fubarlabs/tartan-fubar/pcb/tartan.kicad_pcb

## KiCad design pcb/tartan.kicad_pcb (2024-03-26)

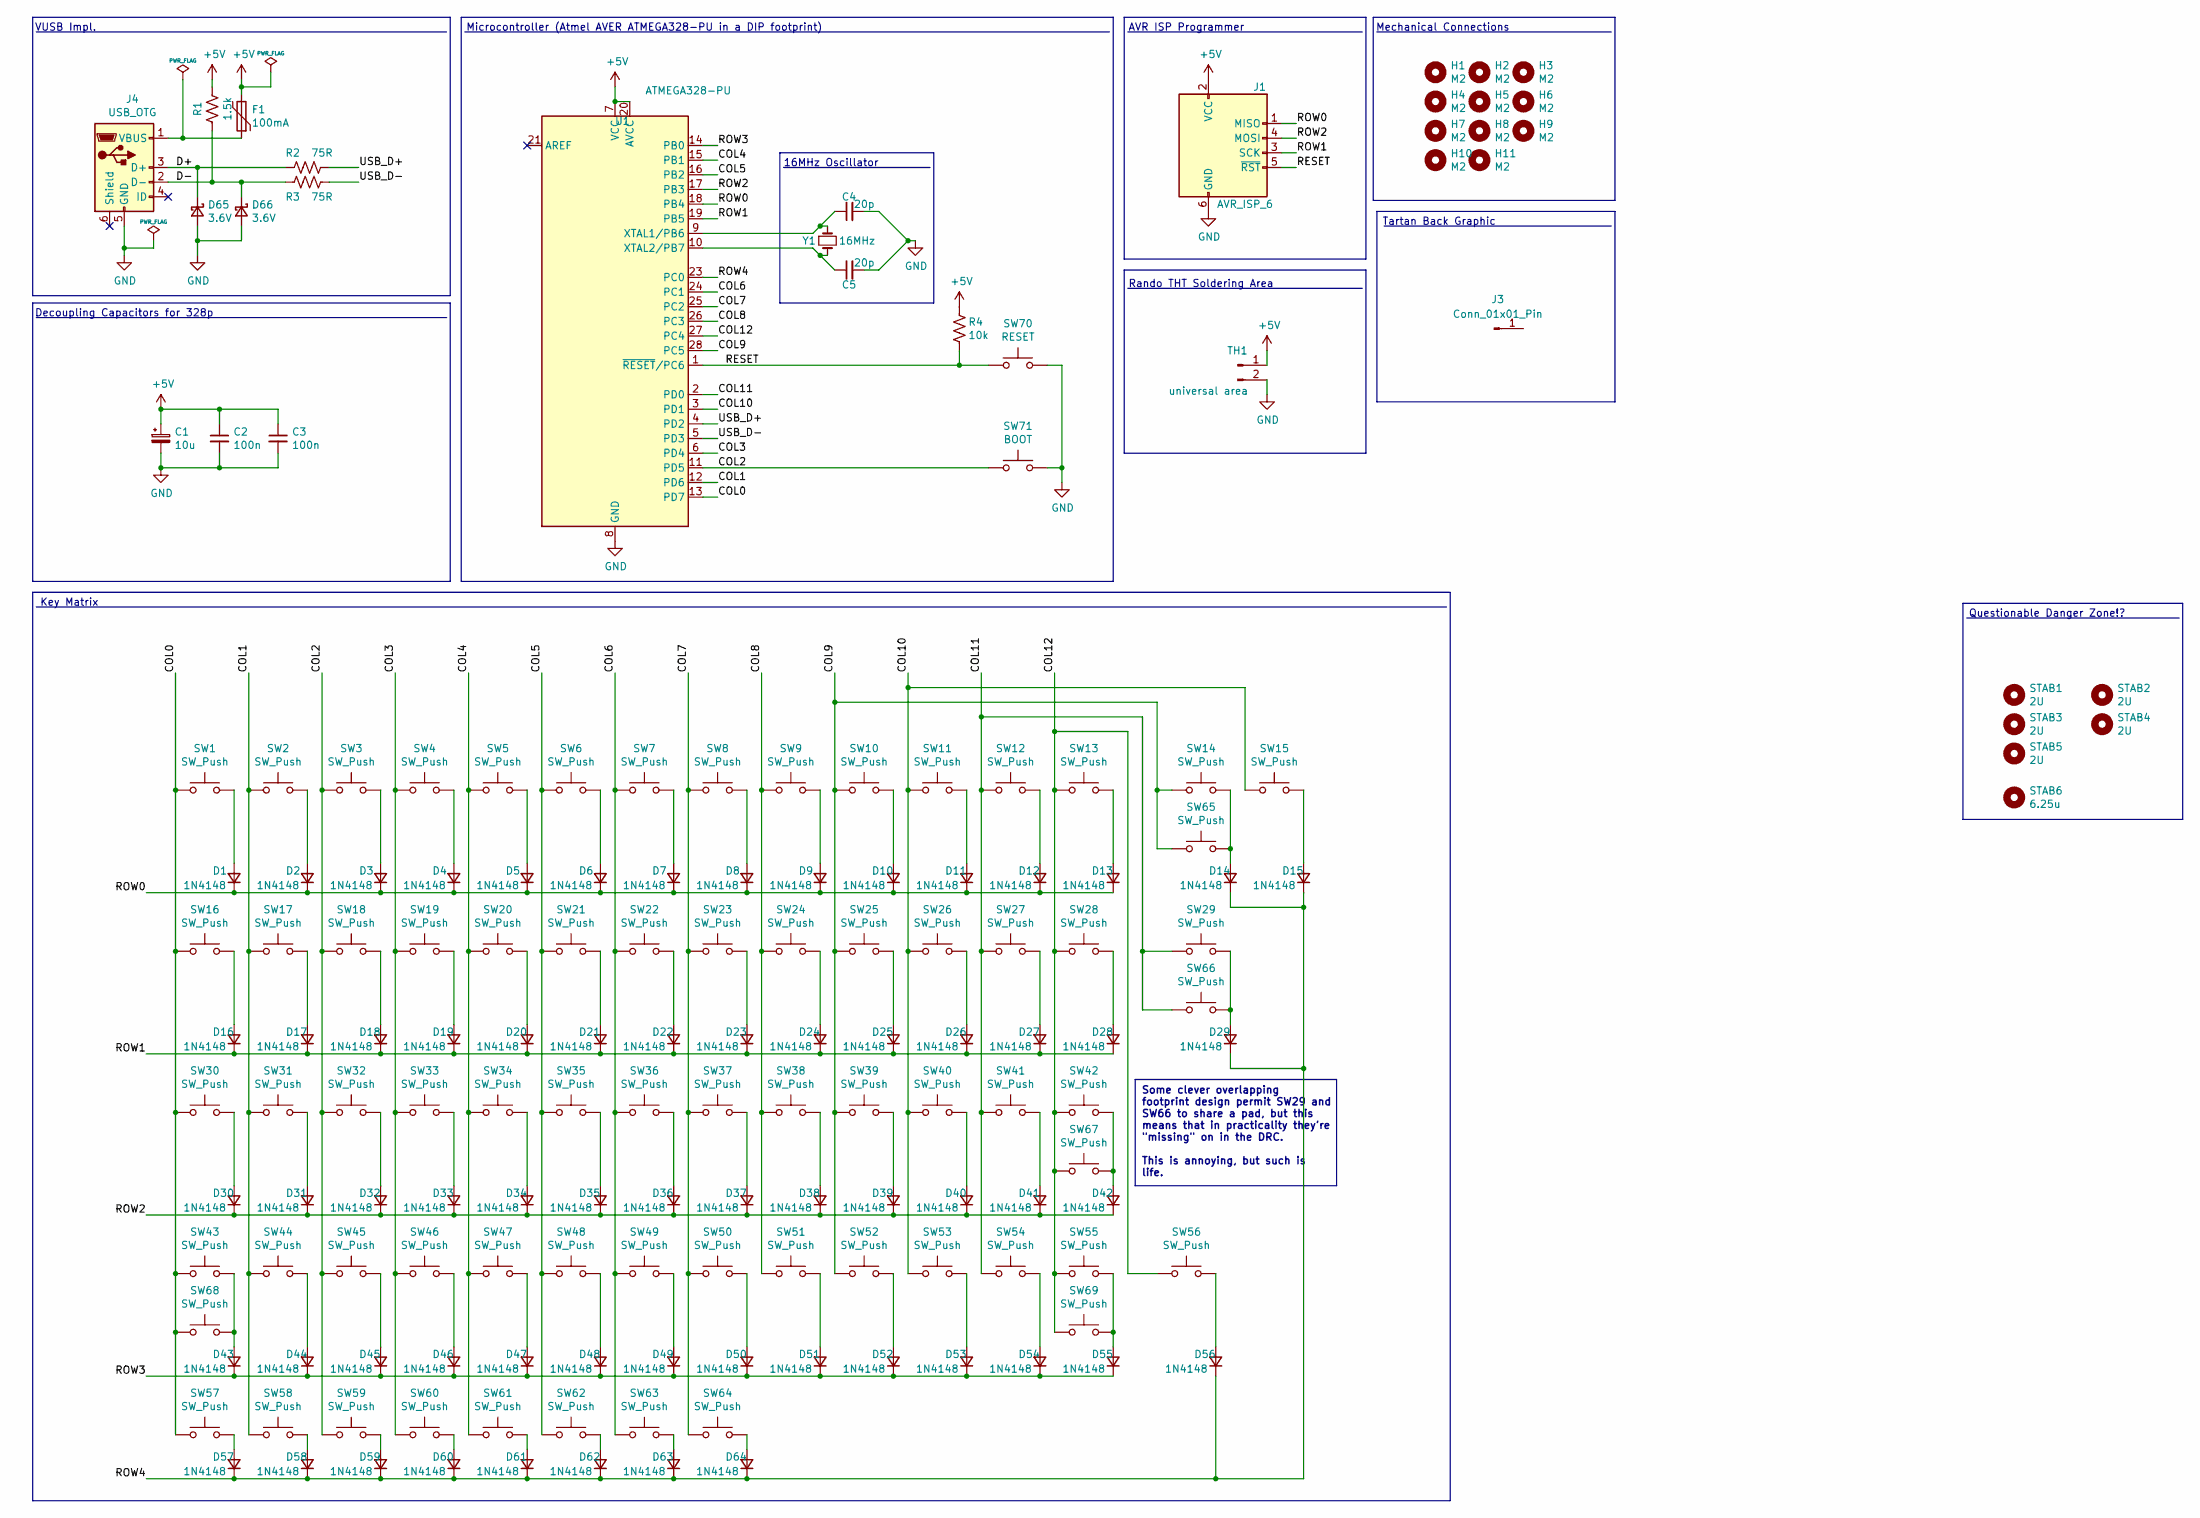
[picture p1: schematic tartan.kicad_sch, Tartan v0.99]

Parts:
C1: 10u; CP_Radial_D4.0mm_P1.50mm
C2, C3: 100n; C_Disc_D4.3mm_W1.9mm_P5.00mm
C4, C5: 20p; C_Disc_D3.0mm_W1.6mm_P2.50mm
D1, D2, D3, D4, D5, D6, D7, D8, D9, D10, D11, D12, D13, D14, D15, D16, D17, D18, D19, D20, D21, D22, D23, D24, D25, D26, D27, D28, D29, D30, D31, D32, D33, D34, D35, D36, D37, D38, D39, D40, D41, D42, D43, D44, D45, D46, D47, D48, D49, D50, D51, D52, D53, D54, D55, D56, D57, D58, D59, D60, D61, D62, D63, D64: 1N4148; D_DO-35_SOD27_P5.08mm_Horizontal
D65, D66: 3.6V; D_DO-35_SOD27_P5.08mm_Horizontal
F1: 100mA; polyfuse_5.1mm
H1, H2, H3, H4, H5, H6, H7, H8, H9, H10, H11: M2; MountingHole_2.2mm_M2
J1: AVR_ISP_6; PinHeader_2x03_P2.54mm_Vertical
J3: Conn_01x01_Pin; bottom1_mask
J4: USB_OTG; USB B THT 1734510-1_TEC
R1: 1.5k; R_Axial_DIN0204_L3.6mm_D1.6mm_P5.08mm_Horizontal
R2, R3: 75R; R_Axial_DIN0204_L3.6mm_D1.6mm_P5.08mm_Horizontal
R4: 10k; R_Axial_DIN0204_L3.6mm_D1.6mm_P5.08mm_Horizontal
STAB1, STAB2, STAB3, STAB4, STAB5: 2U; STAB_MX_2u
STAB6: 6.25u; STAB_MX_6.25u
SW1, SW2, SW3, SW4, SW5, SW6, SW7, SW8, SW9, SW10, SW11, SW12, SW13, SW14, SW15, SW17, SW18, SW19, SW20, SW21, SW22, SW23, SW24, SW25, SW26, SW27, SW28, SW31, SW32, SW33, SW34, SW35, SW36, SW37, SW38, SW39, SW40, SW41, SW42, SW43, SW44, SW45, SW46, SW47, SW48, SW49, SW50, SW51, SW52, SW53, SW54, SW56, SW60, SW65, SW67, SW68, SW69: SW_Push; SW_Cherry_MX1A_1.00u_PCB
SW16, SW29: SW_Push; SW_Cherry_MX1A_1.50u_PCB
SW30, SW55: SW_Push; SW_Cherry_MX1A_1.75u_PCB
SW57, SW58, SW59, SW61, SW62, SW63, SW64: SW_Push; SW_Cherry_MX1A_1.25u_PCB
SW66: SW_Push; Tartan_SW_Cherry_MX1A_1.50u_PCB
SW70: RESET; SW_PUSH_6mm
SW71: BOOT; SW_PUSH_6mm
TH1: universal area; universal_area
U1: ATMEGA328-PU; DIP-28_W7.62mm
Y1: 16MHz; Crystal_HC49-4H_Vertical

Connections:
+5V: C1.1, C2.1, C3.1, F1.2, J1.2 (VCC), R1.2, R4.1, TH1.1, U1.7 (VCC), U1.20 (AVCC)
/COL0: SW1.2, SW16.2, SW30.2, SW43.2, SW57.2, SW68.2, U1.13 (PD7)
/COL1: SW2.2, SW17.2, SW31.2, SW44.2, SW58.2, U1.12 (PD6)
/COL2: SW3.2, SW18.2, SW32.2, SW45.2, SW59.2, SW71.1, U1.11 (PD5)
/COL3: SW4.2, SW19.2, SW33.2, SW46.2, SW60.2, U1.6 (PD4)
/COL4: SW5.2, SW20.2, SW34.2, SW47.2, SW61.2, U1.15 (PB1)
/COL5: SW6.2, SW21.2, SW35.2, SW48.2, SW62.2, U1.16 (PB2)
/COL6: SW7.2, SW22.2, SW36.2, SW49.2, SW63.2, U1.24 (PC1)
/COL7: SW8.2, SW23.2, SW37.2, SW50.2, SW64.2, U1.25 (PC2)
/COL8: SW9.2, SW24.2, SW38.2, SW51.2, U1.26 (PC3)
/COL9: SW10.2, SW14.2, SW25.2, SW39.2, SW52.2, SW65.2, U1.28 (PC5)
/COL10: SW11.2, SW15.2, SW26.2, SW40.2, SW53.2, U1.3 (PD1)
/COL11: SW12.2, SW27.2, SW29.2, SW41.2, SW54.2, SW66.2, U1.2 (PD0)
/COL12: SW13.2, SW28.2, SW42.2, SW55.2, SW56.2, SW67.2, SW69.2, U1.27 (PC4)
/D+: D65.1 (K), J4.3 (D+), R2.2
/D-: D66.1 (K), J4.2 (D-), R1.1, R3.2
/RESET: J1.5 (~RST), R4.2, SW70.1, U1.1 (~RESET/PC6)
/ROW0: D1.1 (K), D2.1 (K), D3.1 (K), D4.1 (K), D5.1 (K), D6.1 (K), D7.1 (K), D8.1 (K), D9.1 (K), D10.1 (K), D11.1 (K), D12.1 (K), D13.1 (K), J1.1 (MISO), U1.18 (PB4)
/ROW1: D16.1 (K), D17.1 (K), D18.1 (K), D19.1 (K), D20.1 (K), D21.1 (K), D22.1 (K), D23.1 (K), D24.1 (K), D25.1 (K), D26.1 (K), D27.1 (K), D28.1 (K), J1.3 (SCK), U1.19 (PB5)
/ROW2: D30.1 (K), D31.1 (K), D32.1 (K), D33.1 (K), D34.1 (K), D35.1 (K), D36.1 (K), D37.1 (K), D38.1 (K), D39.1 (K), D40.1 (K), D41.1 (K), D42.1 (K), J1.4 (MOSI), U1.17 (PB3)
/ROW3: D43.1 (K), D44.1 (K), D45.1 (K), D46.1 (K), D47.1 (K), D48.1 (K), D49.1 (K), D50.1 (K), D51.1 (K), D52.1 (K), D53.1 (K), D54.1 (K), D55.1 (K), U1.14 (PB0)
/ROW4: D14.1 (K), D15.1 (K), D29.1 (K), D56.1 (K), D57.1 (K), D58.1 (K), D59.1 (K), D60.1 (K), D61.1 (K), D62.1 (K), D63.1 (K), D64.1 (K), U1.23 (PC0)
/USB_D+: R2.1, U1.4 (PD2)
/USB_D-: R3.1, U1.5 (PD3)
GND: C1.2, C2.2, C3.2, C4.2, C5.2, D65.2 (A), D66.2 (A), J1.6 (GND), J4.5 (GND), SW70.2, SW71.2, TH1.2, U1.8 (GND), U1.22 (GND)
unnamed: D1.2 (A), SW1.1
unnamed: D2.2 (A), SW2.1
unnamed: D3.2 (A), SW3.1
unnamed: D4.2 (A), SW4.1
unnamed: D5.2 (A), SW5.1
unnamed: D6.2 (A), SW6.1
unnamed: D7.2 (A), SW7.1
unnamed: D8.2 (A), SW8.1
unnamed: D9.2 (A), SW9.1
unnamed: D10.2 (A), SW10.1
unnamed: D11.2 (A), SW11.1
unnamed: D12.2 (A), SW12.1
unnamed: D13.2 (A), SW13.1
unnamed: D14.2 (A), SW14.1, SW65.1
unnamed: D15.2 (A), SW15.1
unnamed: D16.2 (A), SW16.1
unnamed: D17.2 (A), SW17.1
unnamed: D18.2 (A), SW18.1
unnamed: D19.2 (A), SW19.1
unnamed: D20.2 (A), SW20.1
unnamed: D21.2 (A), SW21.1
unnamed: D22.2 (A), SW22.1
unnamed: D23.2 (A), SW23.1
unnamed: D24.2 (A), SW24.1
unnamed: D25.2 (A), SW25.1
unnamed: D26.2 (A), SW26.1
unnamed: D27.2 (A), SW27.1
unnamed: D28.2 (A), SW28.1
unnamed: D29.2 (A), SW29.1, SW66.1
unnamed: D30.2 (A), SW30.1
unnamed: D31.2 (A), SW31.1
unnamed: D32.2 (A), SW32.1
unnamed: D33.2 (A), SW33.1
unnamed: D34.2 (A), SW34.1
unnamed: D35.2 (A), SW35.1
unnamed: D36.2 (A), SW36.1
unnamed: D37.2 (A), SW37.1
unnamed: D38.2 (A), SW38.1
unnamed: D39.2 (A), SW39.1
unnamed: D40.2 (A), SW40.1
unnamed: D41.2 (A), SW41.1
unnamed: D42.2 (A), SW42.1, SW67.1
unnamed: D43.2 (A), SW43.1, SW68.1
unnamed: D44.2 (A), SW44.1
unnamed: D45.2 (A), SW45.1
unnamed: D46.2 (A), SW46.1
unnamed: D47.2 (A), SW47.1
unnamed: D48.2 (A), SW48.1
unnamed: D49.2 (A), SW49.1
unnamed: D50.2 (A), SW50.1
unnamed: D51.2 (A), SW51.1
unnamed: D52.2 (A), SW52.1
unnamed: D53.2 (A), SW53.1
unnamed: D54.2 (A), SW54.1
unnamed: D55.2 (A), SW55.1, SW69.1
unnamed: D56.2 (A), SW56.1
unnamed: D57.2 (A), SW57.1
unnamed: D58.2 (A), SW58.1
unnamed: D59.2 (A), SW59.1
unnamed: D60.2 (A), SW60.1
unnamed: D61.2 (A), SW61.1
unnamed: D62.2 (A), SW62.1
unnamed: D63.2 (A), SW63.1
unnamed: D64.2 (A), SW64.1
unnamed: F1.1, J4.1 (VBUS)
unnamed: C4.1, U1.9 (XTAL1/PB6), Y1.1
unnamed: C5.1, U1.10 (XTAL2/PB7), Y1.2

Notes on the sheet:
Some clever overlapping footprint design permit SW29 and SW66 to share a pad, but this means that in practicality they're "missing" on in the DRC. This is annoying, but such is life.
Decoupling Capacitors for 328p
VUSB Impl.
Mechanical Connections
Rando THT Soldering Area
Questionable Danger Zone!?
16MHz Oscillator
Tartan Back Graphic
Key Matrix
AVR ISP Programmer
Microcontroller (Atmel AVER ATMEGA328-PU in a DIP footprint)

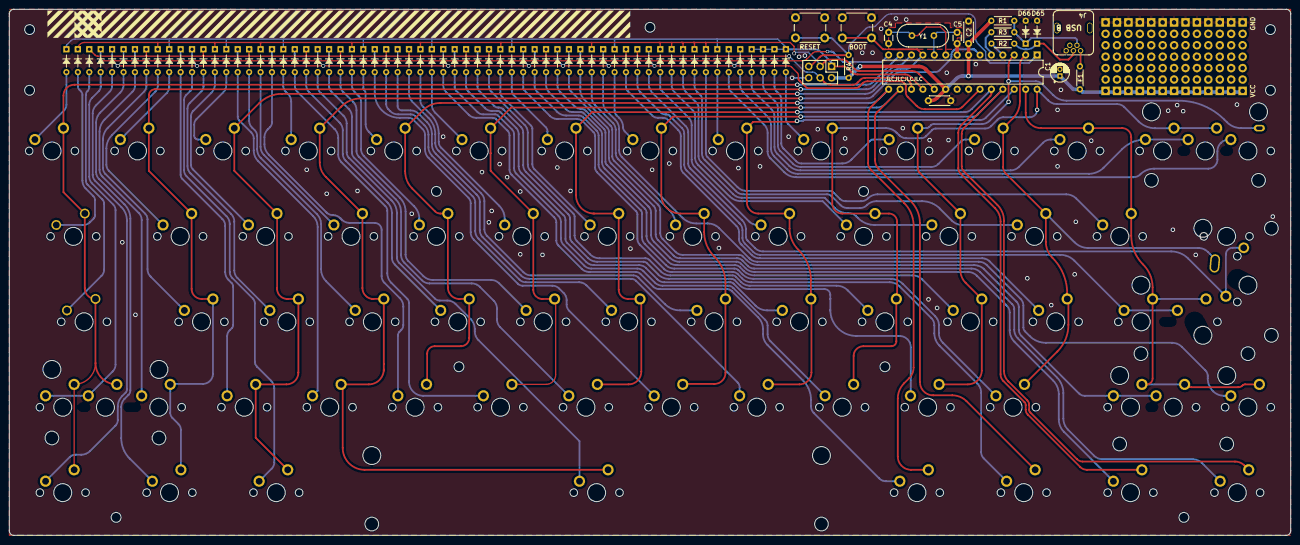
[picture p2: board tartan.kicad_pcb from above]

Board: 2 copper layers, 285.0 x 117.0 mm, 170 parts (1 on the bottom side), 92 nets.
