fubarlabs/tartan-fubar/(commit log)

2023-10-25 Added new routing for matrix, still need to add USB C.
    [tartan.kicad_pcb, tartan.kicad_sch]
2023-10-26 Fix broken traces and too small vias... hopefully.
    [tartan.kicad_pcb, tartan_bottom.kicad_pcb]
2023-11-05 Updated to use new footprints, removed backups directory, as well as specifically removed bottom PCB for sanity savings.
    [tartan.kicad_pcb, tartan.kicad_sch, tartan_bottom.kicad_pcb]
2023-11-05 Little thing called broken traces updated. Rounded some more too I guess.
    [tartan.kicad_pcb]
2023-11-12 Rounded traces and re-added silks. Oops.
    [tartan.kicad_pcb]
2023-11-15 Small cleanup in latest nightly to hopefully minimize truly broken traces.
    [tartan.kicad_pcb, tartan.kicad_sch]
2023-11-23 Update to new USB B that Ben found.
    new file: pcb/sym-lib-table
    [tartan.kicad_pcb, tartan.kicad_sch]
2023-12-22 Added stabilizers back and hopefully fixed a bunch of issues (tm).
    [tartan.kicad_pcb, tartan.kicad_sch, tartan.sch]
2024-03-26 Added render pipeline to have screenshots.
    [tartan.kicad_pcb]
