fubarlabs/tartan-fubar/(notices)

Notices in the files:
pcb/tartan.kicad_pcb:
(c)2019 Takuya Urakawa, Dm9Records, 5z6p.com
